afonsus1997/V3S-devboard/README.md

# V3S-devboard

## Hardware

Using V3S lib from https://github.com/balmerdx/AllwinnerV3S_KiCad

## Software

Build environment based on Funkey project
