afonsus1997/V3S-devboard/Hardware/V3S-devboard-module/V3S-devboard-module.kicad_pcb

## KiCad design Hardware/V3S-devboard-module/V3S-devboard-module.kicad_pcb (2024-05-04)

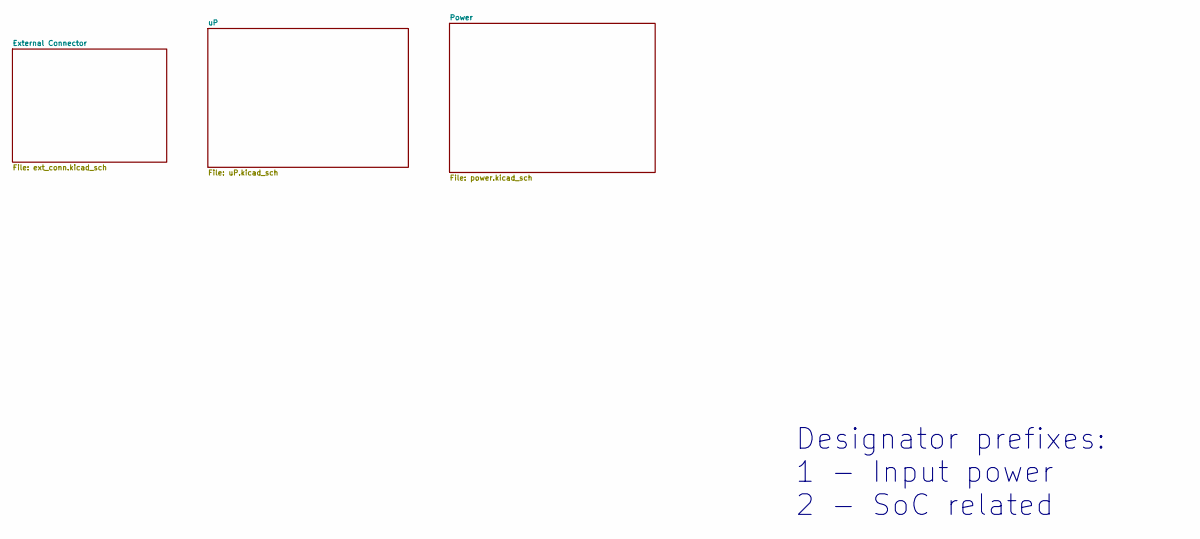
[picture p1: schematic V3S-devboard-module.kicad_sch]

Notes on the sheet:
Designator prefixes: 1 - Input power 2 - SoC related

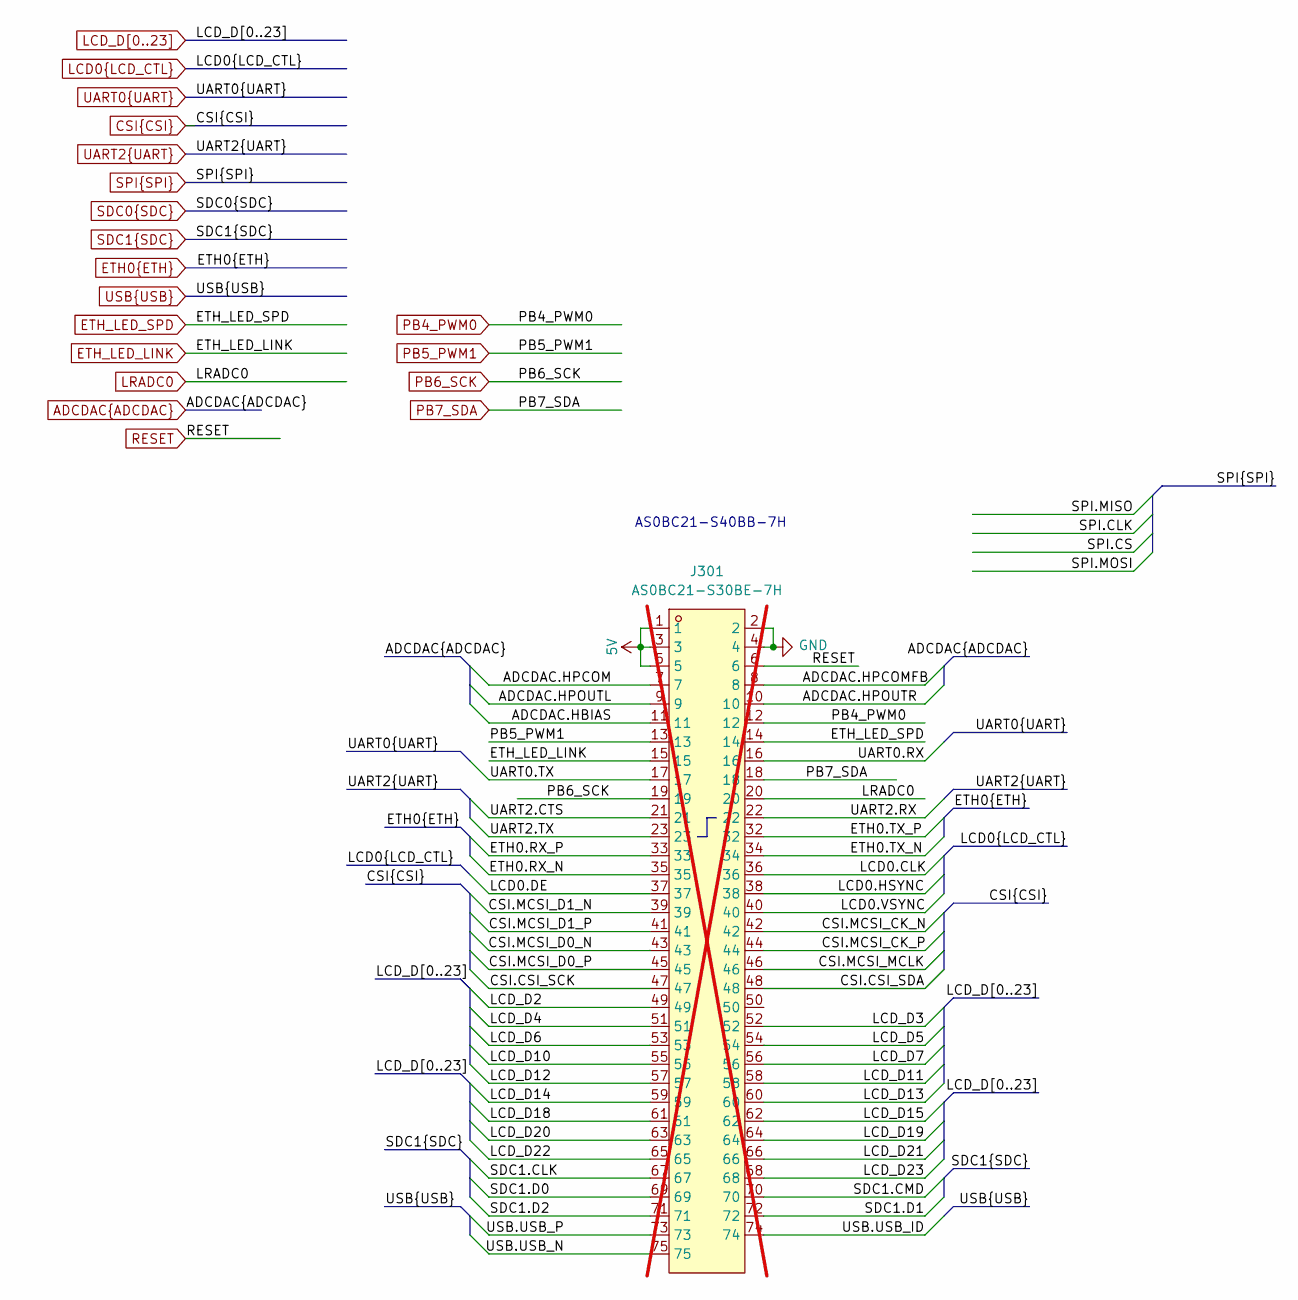
[picture p2: schematic ext_conn.kicad_sch, Power]

Parts:
J301: AS0BC21-S30BE-7H; m2-padKeyE; LCSC Part C3020019; not fitted

Connections:
5V: J301.1, J301.3, J301.5; also elsewhere on the board
ADCDAC.HBIAS: J301.11; also elsewhere on the board
ADCDAC.HPCOM: J301.7; also elsewhere on the board
ADCDAC.HPCOMFB: J301.8; also elsewhere on the board
ADCDAC.HPOUTL: J301.9; also elsewhere on the board
ADCDAC.HPOUTR: J301.10; also elsewhere on the board
CSI.CSI_SCK: J301.47; also elsewhere on the board
CSI.CSI_SDA: J301.48; also elsewhere on the board
CSI.MCSI_CK_N: J301.42; also elsewhere on the board
CSI.MCSI_CK_P: J301.44; also elsewhere on the board
CSI.MCSI_D0_N: J301.43; also elsewhere on the board
CSI.MCSI_D0_P: J301.45; also elsewhere on the board
CSI.MCSI_D1_N: J301.39; also elsewhere on the board
CSI.MCSI_D1_P: J301.41; also elsewhere on the board
CSI.MCSI_MCLK: J301.46; also elsewhere on the board
ETH0.RX_N: J301.35; also elsewhere on the board
ETH0.RX_P: J301.33; also elsewhere on the board
ETH0.TX_N: J301.34; also elsewhere on the board
ETH0.TX_P: J301.32; also elsewhere on the board
ETH_LED_LINK: J301.15; also elsewhere on the board
ETH_LED_SPD: J301.14; also elsewhere on the board
GND: J301.2, J301.4; also elsewhere on the board
LCD0.CLK: J301.36; also elsewhere on the board
LCD0.DE: J301.37; also elsewhere on the board
LCD0.HSYNC: J301.38; also elsewhere on the board
LCD0.VSYNC: J301.40; also elsewhere on the board
LCD_D2: J301.49; also elsewhere on the board
LCD_D3: J301.52; also elsewhere on the board
LCD_D4: J301.51; also elsewhere on the board
LCD_D5: J301.54; also elsewhere on the board
LCD_D6: J301.53; also elsewhere on the board
LCD_D7: J301.56; also elsewhere on the board
LCD_D10: J301.55; also elsewhere on the board
LCD_D11: J301.58; also elsewhere on the board
LCD_D12: J301.57; also elsewhere on the board
LCD_D13: J301.60; also elsewhere on the board
LCD_D14: J301.59; also elsewhere on the board
LCD_D15: J301.62; also elsewhere on the board
LCD_D18: J301.61; also elsewhere on the board
LCD_D19: J301.64; also elsewhere on the board
LCD_D20: J301.63; also elsewhere on the board
LCD_D21: J301.66; also elsewhere on the board
LCD_D22: J301.65; also elsewhere on the board
LCD_D23: J301.68; also elsewhere on the board
LRADC0: J301.20; also elsewhere on the board
PB4_PWM0: J301.12; also elsewhere on the board
PB5_PWM1: J301.13; also elsewhere on the board
PB6_SCK: J301.19; also elsewhere on the board
PB7_SDA: J301.18; also elsewhere on the board
RESET: J301.6; also elsewhere on the board
SDC1.CLK: J301.67; also elsewhere on the board
SDC1.CMD: J301.70; also elsewhere on the board
SDC1.D0: J301.69; also elsewhere on the board
SDC1.D1: J301.72; also elsewhere on the board
SDC1.D2: J301.71; also elsewhere on the board
UART0.RX: J301.16; also elsewhere on the board
UART0.TX: J301.17; also elsewhere on the board
UART2.CTS: J301.21; also elsewhere on the board
UART2.RX: J301.22; also elsewhere on the board
UART2.TX: J301.23; also elsewhere on the board
USB.USB_ID: J301.74; also elsewhere on the board
USB.USB_N: J301.75; also elsewhere on the board
USB.USB_P: J301.73; also elsewhere on the board

Notes on the sheet:
AS0BC21-S40BB-7H

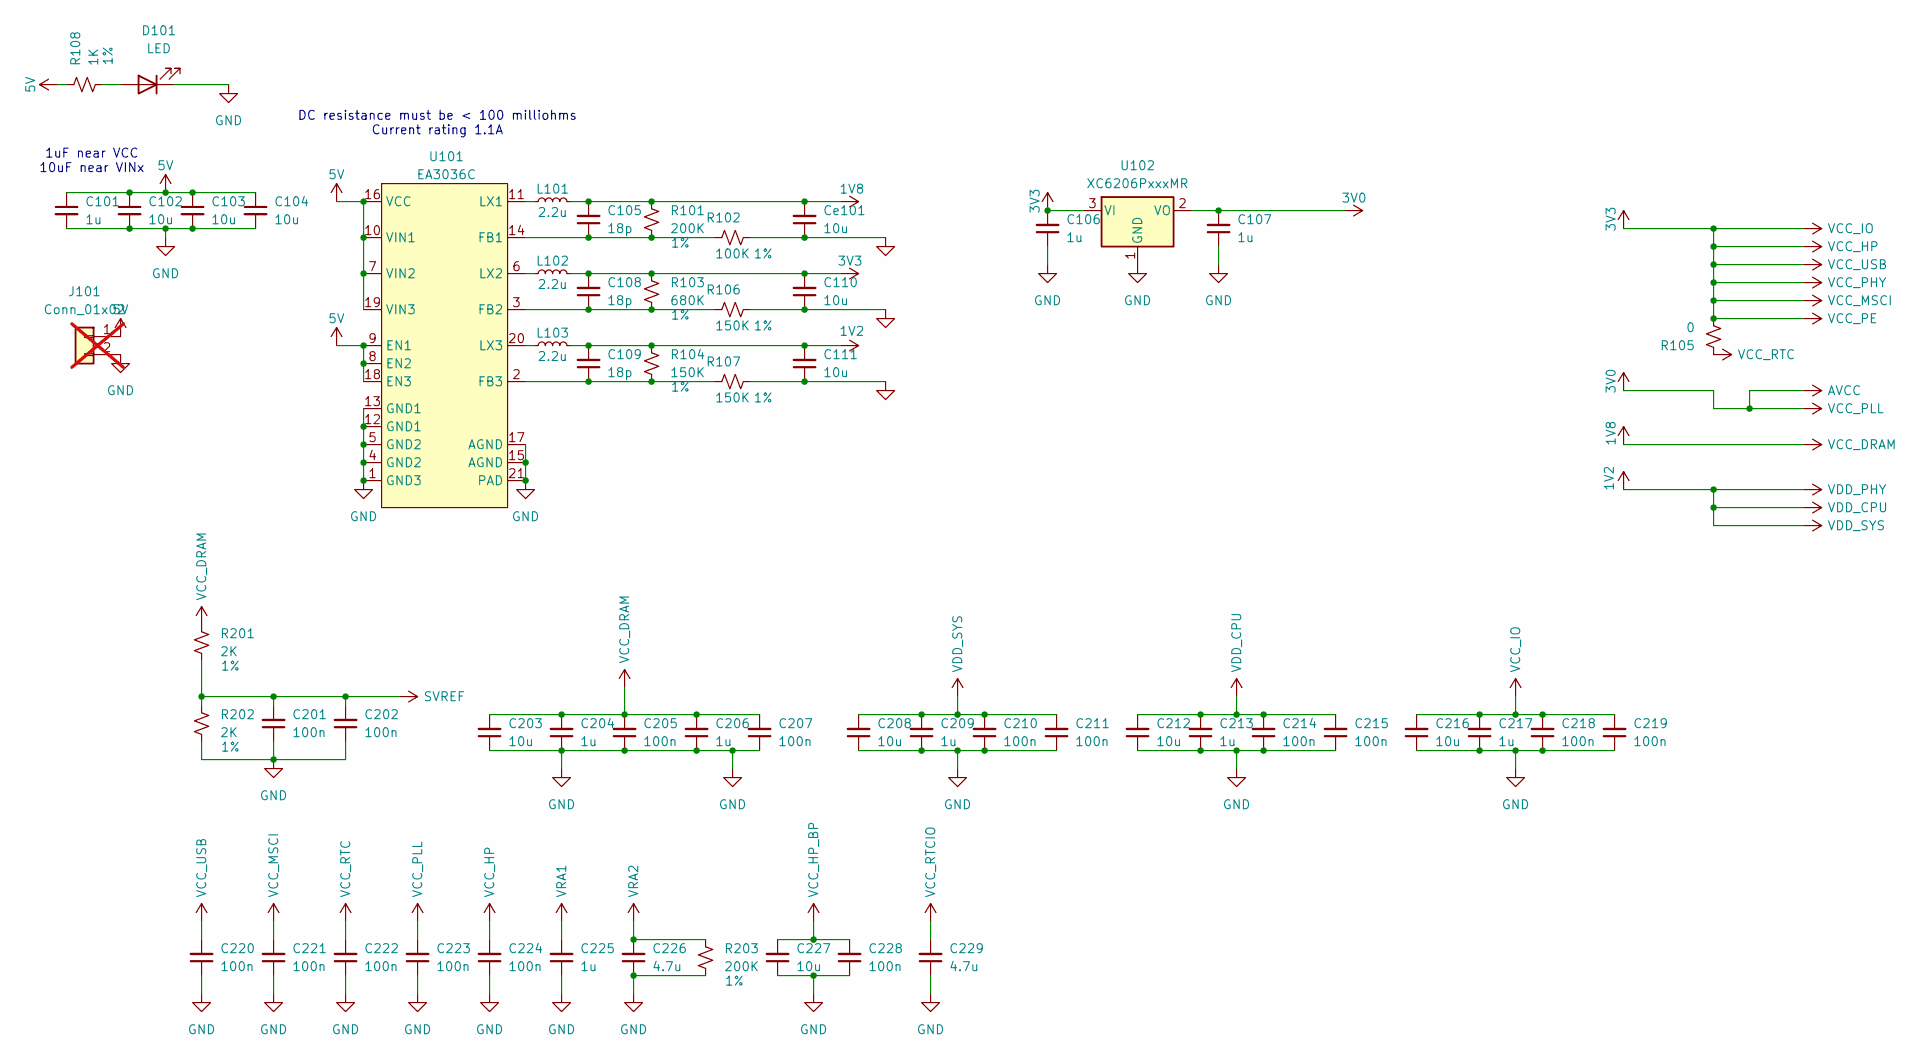
[picture p3: schematic power.kicad_sch]

Parts:
C101, C106, C107, C204, C206, C209, C213, C217, C225: 1u; C_0603_1608Metric; LCSC C5673
C102, C103, C104, C110, C111, C203, C208, C212, C216, C227: 10u; C_0603_1608Metric; LCSC C1691
C105, C108, C109: 18p; C_0402_1005Metric; LCSC C541431
C201, C202, C205, C207, C210, C211, C214, C215, C218, C219, C220, C221, C222, C223, C224, C228: 100n; C_0402_1005Metric; LCSC C1525
C226, C229: 4.7u; C_0603_1608Metric; LCSC C1705
Ce101: 10u; C_0603_1608Metric; LCSC C1691
D101: LED; LED_0603_1608Metric
J101: Conn_01x02; PinHeader_1x02_P2.54mm_Vertical; not fitted
L101, L102, L103: 2.2u; L_1008_2520Metric; LCSC C86092
R101, R203: 200K; R_0402_1005Metric; LCSC C114763
R102: 100K; R_0402_1005Metric; LCSC C60491
R103: 680K; R_0402_1005Metric; LCSC C163456
R104, R106, R107: 150K; R_0402_1005Metric; LCSC C93947
R105: 0; R_0402_1005Metric; LCSC C106231
R108: 1K; R_0402_1005Metric; LCSC C114763
R201, R202: 2K; R_0402_1005Metric; LCSC C60488
U101: EA3036C; WQFN-20-1EP_3x3mm_P0.4mm_EP1.7x1.7mm; LCSC C570857
U102: XC6206PxxxMR; SOT-23-3; LCSC C5148691

Connections:
1V2: C109.2, C111.2, C208.2, C209.2, C210.2, C211.2, C212.2, C213.2, C214.2, C215.2, L103.2, R104.1; also elsewhere on the board
1V8: C105.2, C203.2, C204.2, C205.2, C206.2, C207.2, Ce101.2, L101.2, R101.1, R201.1; also elsewhere on the board
3V0: C107.2, C223.2, U102.2 (VO); also elsewhere on the board
3V3: C106.2, C108.2, C110.2, C216.2, C217.2, C218.2, C219.2, C220.2, C221.2, C224.2, L102.2, R103.1, R105.2, U102.3 (VI); also elsewhere on the board
5V: C101.1, C102.1, C103.1, C104.1, J101.1, R108.1, U101.7 (VIN2), U101.8 (EN2), U101.9 (EN1), U101.10 (VIN1), U101.16 (VCC), U101.18 (EN3), U101.19 (VIN3); also elsewhere on the board
GND: C101.2, C102.2, C103.2, C104.2, C106.1, C107.1, C110.1, C111.1, C201.1, C202.1, C203.1, C204.1, C205.1, C206.1, C207.1, C208.1, C209.1, C210.1, C211.1, C212.1, C213.1, C214.1, C215.1, C216.1, C217.1, C218.1, C219.1, C220.1, C221.1, C222.1, C223.1, C224.1, C225.1, C226.1, C227.1, C228.1, C229.1, Ce101.1, D101.1 (K), J101.2, R102.2, R106.2, R107.2, R202.2, R203.2, U101.1 (GND3), U101.4 (GND2), U101.5 (GND2), U101.12 (GND1), U101.13 (GND1), U101.15 (AGND), U101.17 (AGND), U101.21 (PAD), U102.1 (GND); also elsewhere on the board
unnamed: D101.2 (A), R108.2
unnamed: C105.1, R101.2, R102.1, U101.14 (FB1)
unnamed: C108.1, R103.2, R106.1, U101.3 (FB2)
unnamed: C109.1, R104.2, R107.1, U101.2 (FB3)
unnamed: L101.1, U101.11 (LX1)
unnamed: L102.1, U101.6 (LX2)
unnamed: L103.1, U101.20 (LX3)
SVREF: C201.2, C202.2, R201.2, R202.1; also elsewhere on the board
VCC_HP_BP: C227.2, C228.2; also elsewhere on the board
VCC_RTC: C222.2, R105.1; also elsewhere on the board
VCC_RTCIO: C229.2; also elsewhere on the board
VRA1: C225.2; also elsewhere on the board
VRA2: C226.2, R203.1; also elsewhere on the board

Notes on the sheet:
DC resistance must be < 100 milliohms Current rating 1.1A
1uF near VCC 10uF near VINx

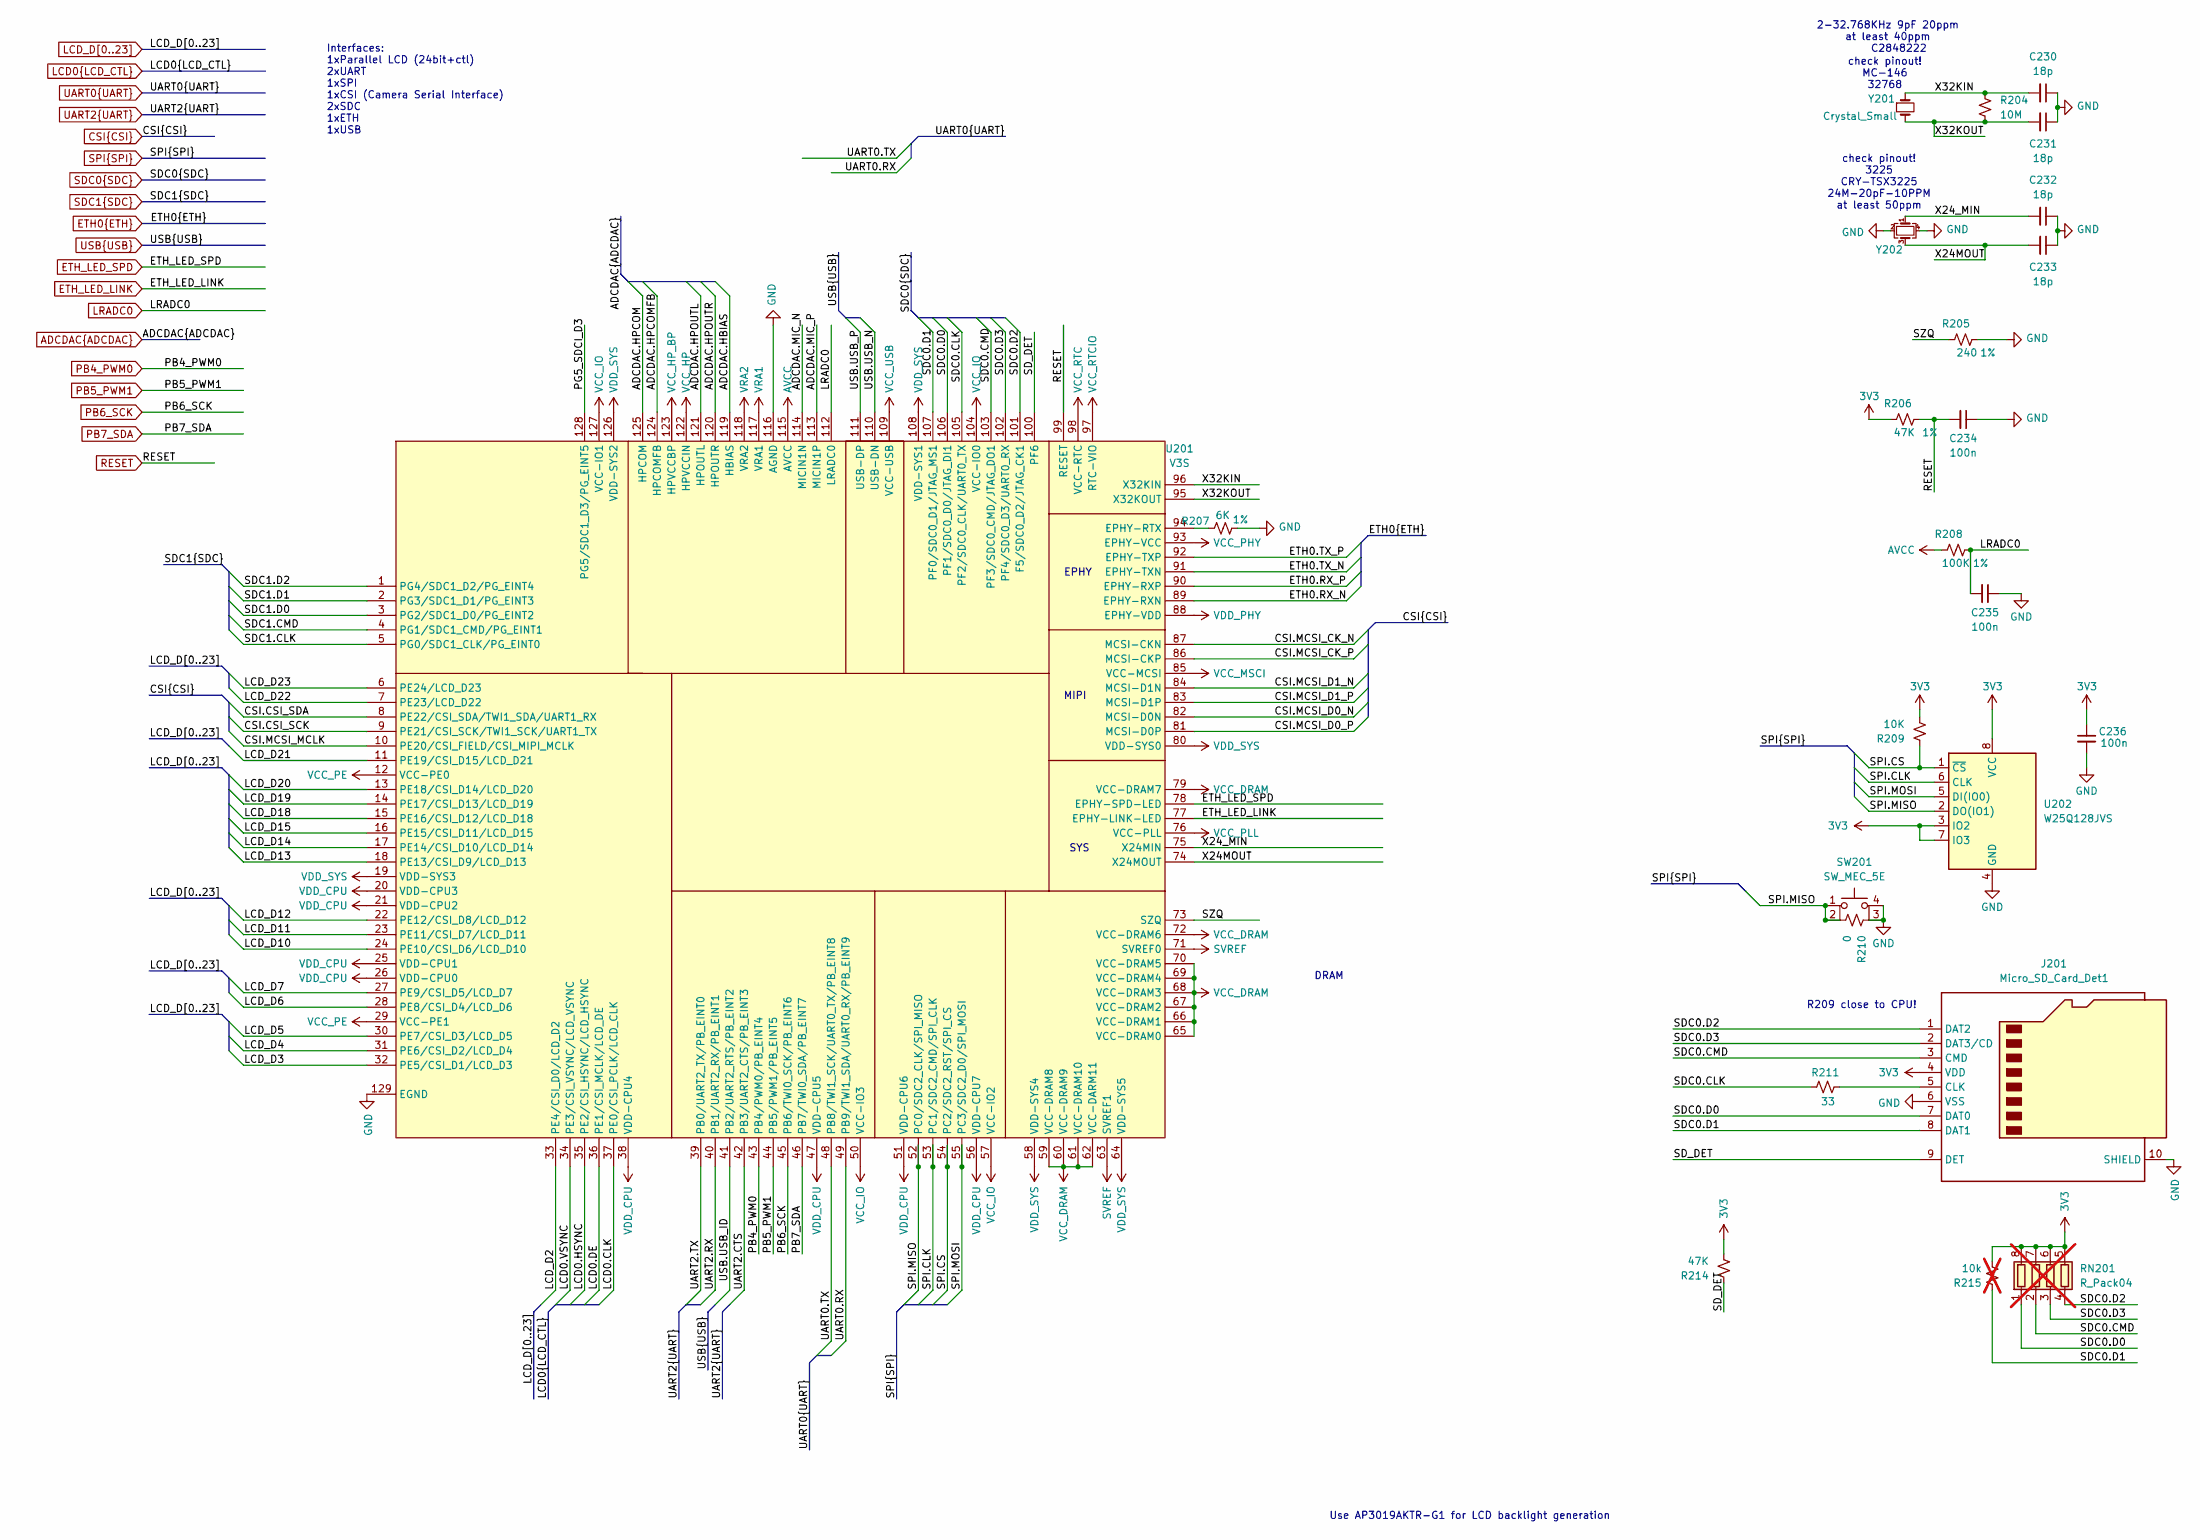
[picture p4: schematic uP.kicad_sch]

Parts:
C230, C231, C232, C233: 18p; C_0402_1005Metric; LCSC C541431
C234, C235, C236: 100n; C_0402_1005Metric; LCSC C1525
J201: Micro_SD_Card_Det1; J_sd_micro_socket; LCSC C7529389
R204: 10M; R_0402_1005Metric; LCSC C138067
R205: 240; R_0402_1005Metric; LCSC C114755
R206, R214: 47K; R_0402_1005Metric; LCSC C93943
R207: 6K; R_0805_2012Metric; LCSC C2828725
R208: 100K; R_0402_1005Metric; LCSC C60491
R209: 10K; R_0402_1005Metric; LCSC C60490
R210: 0; R_0402_1005Metric; LCSC C106231
R211: 33; R_0402_1005Metric; LCSC C138002
R215: 10k; R_0402_1005Metric; LCSC C60490; not fitted
RN201: R_Pack04; R_Array_Concave_4x0402; LCSC C1736647; not fitted
SW201: SW_MEC_5E; SW_SKRPACE010; LCSC C139797
U201: V3S; LQFP-128_L14.0-W14.0-P0.40-LS16.0-BL-EP5.0; LCSC C2687449
U202: W25Q128JVS; SOIC-8_5.23x5.23mm_P1.27mm; LCSC C97521
Y201: Crystal_Small; Crystal_SMD_3215-2Pin_3.2x1.5mm; LCSC C2848222
Y202: Crystal_GND24_Small; Crystal_SMD_2520-4Pin_2.5x2.0mm; LCSC C15643

Connections:
1V2: U201.19 (VDD-SYS3), U201.20 (VDD-CPU3), U201.21 (VDD-CPU2), U201.25 (VDD-CPU1), U201.26 (VDD-CPU0), U201.38 (VDD-CPU4), U201.47 (VDD-CPU5), U201.51 (VDD-CPU6), U201.56 (VDD-CPU7), U201.58 (VDD-SYS4), U201.64 (VDD-SYS5), U201.80 (VDD-SYS0), U201.88 (EPHY-VDD), U201.108 (VDD-SYS1), U201.126 (VDD-SYS2); also elsewhere on the board
1V8: U201.59 (VCC-DRAM8), U201.60 (VCC-DRAM9), U201.61 (VCC-DRAM10), U201.62 (VCC-DARM11), U201.65 (VCC-DRAM0), U201.66 (VCC-DRAM1), U201.67 (VCC-DRAM2), U201.68 (VCC-DRAM3), U201.69 (VCC-DRAM4), U201.70 (VCC-DRAM5), U201.72 (VCC-DRAM6), U201.79 (VCC-DRAM7); also elsewhere on the board
3V0: R208.1, U201.76 (VCC-PLL), U201.115 (AVCC); also elsewhere on the board
3V3: C236.1, J201.4 (VDD), R206.1, R209.2, R214.2, R215.2, RN201.5 (R4.2), RN201.6 (R3.2), RN201.7 (R2.2), RN201.8 (R1.2), U201.12 (VCC-PE0), U201.29 (VCC-PE1), U201.50 (VCC-IO3), U201.57 (VCC-IO2), U201.85 (VCC-MCSI), U201.93 (EPHY-VCC), U201.104 (VCC-IO0), U201.109 (VCC-USB), U201.122 (HPVCCIN), U201.127 (VCC-IO1), U202.3 (IO2), U202.7 (IO3), U202.8 (VCC); also elsewhere on the board
/uP/PG5_SDCI_D3: U201.128 (PG5/SDC1_D3/PG_EINT5)
/uP/SD_DET: J201.9 (DET), R214.1, U201.100 (PF6)
/uP/SZQ: R205.1, U201.73 (SZQ)
/uP/X24MOUT: C233.2, U201.74 (X24MOUT), Y202.3
/uP/X24_MIN: C232.2, U201.75 (X24MIN), Y202.1
/uP/X32KIN: C230.2, R204.1, U201.96 (X32KIN), Y201.1
/uP/X32KOUT: C231.2, R204.2, U201.95 (X32KOUT), Y201.2
ADCDAC.HBIAS: U201.119 (HBIAS); also elsewhere on the board
ADCDAC.HPCOM: U201.125 (HPCOM); also elsewhere on the board
ADCDAC.HPCOMFB: U201.124 (HPCOMFB); also elsewhere on the board
ADCDAC.HPOUTL: U201.121 (HPOUTL); also elsewhere on the board
ADCDAC.HPOUTR: U201.120 (HPOUTR); also elsewhere on the board
ADCDAC.MIC_N: U201.114 (MICIN1N)
ADCDAC.MIC_P: U201.113 (MICIN1P)
CSI.CSI_SCK: U201.9 (PE21/CSI_SCK/TWI1_SCK/UART1_TX); also elsewhere on the board
CSI.CSI_SDA: U201.8 (PE22/CSI_SDA/TWI1_SDA/UART1_RX); also elsewhere on the board
CSI.MCSI_CK_N: U201.87 (MCSI-CKN); also elsewhere on the board
CSI.MCSI_CK_P: U201.86 (MCSI-CKP); also elsewhere on the board
CSI.MCSI_D0_N: U201.82 (MCSI-D0N); also elsewhere on the board
CSI.MCSI_D0_P: U201.81 (MCSI-D0P); also elsewhere on the board
CSI.MCSI_D1_N: U201.84 (MCSI-D1N); also elsewhere on the board
CSI.MCSI_D1_P: U201.83 (MCSI-D1P); also elsewhere on the board
CSI.MCSI_MCLK: U201.10 (PE20/CSI_FIELD/CSI_MIPI_MCLK); also elsewhere on the board
ETH0.RX_N: U201.89 (EPHY-RXN); also elsewhere on the board
ETH0.RX_P: U201.90 (EPHY-RXP); also elsewhere on the board
ETH0.TX_N: U201.91 (EPHY-TXN); also elsewhere on the board
ETH0.TX_P: U201.92 (EPHY-TXP); also elsewhere on the board
ETH_LED_LINK: U201.77 (EPHY-LINK-LED); also elsewhere on the board
ETH_LED_SPD: U201.78 (EPHY-SPD-LED); also elsewhere on the board
GND: C230.1, C231.1, C232.1, C233.1, C234.1, C235.1, C236.2, J201.6 (VSS), J201.10 (SHIELD), R205.2, R207.2, R210.1, SW201.3 (K), SW201.4 (A), U201.116 (AGND), U201.129 (EGND), U202.4 (GND), Y202.2, Y202.4; also elsewhere on the board
LCD0.CLK: U201.37 (PE0/CSI_PCLK/LCD_CLK); also elsewhere on the board
LCD0.DE: U201.36 (PE1/CSI_MCLK/LCD_DE); also elsewhere on the board
LCD0.HSYNC: U201.35 (PE2/CSI_HSYNC/LCD_HSYNC); also elsewhere on the board
LCD0.VSYNC: U201.34 (PE3/CSI_VSYNC/LCD_VSYNC); also elsewhere on the board
LCD_D2: U201.33 (PE4/CSI_D0/LCD_D2); also elsewhere on the board
LCD_D3: U201.32 (PE5/CSI_D1/LCD_D3); also elsewhere on the board
LCD_D4: U201.31 (PE6/CSI_D2/LCD_D4); also elsewhere on the board
LCD_D5: U201.30 (PE7/CSI_D3/LCD_D5); also elsewhere on the board
LCD_D6: U201.28 (PE8/CSI_D4/LCD_D6); also elsewhere on the board
LCD_D7: U201.27 (PE9/CSI_D5/LCD_D7); also elsewhere on the board
LCD_D10: U201.24 (PE10/CSI_D6/LCD_D10); also elsewhere on the board
LCD_D11: U201.23 (PE11/CSI_D7/LCD_D11); also elsewhere on the board
LCD_D12: U201.22 (PE12/CSI_D8/LCD_D12); also elsewhere on the board
LCD_D13: U201.18 (PE13/CSI_D9/LCD_D13); also elsewhere on the board
LCD_D14: U201.17 (PE14/CSI_D10/LCD_D14); also elsewhere on the board
LCD_D15: U201.16 (PE15/CSI_D11/LCD_D15); also elsewhere on the board
LCD_D18: U201.15 (PE16/CSI_D12/LCD_D18); also elsewhere on the board
LCD_D19: U201.14 (PE17/CSI_D13/LCD_D19); also elsewhere on the board
LCD_D20: U201.13 (PE18/CSI_D14/LCD_D20); also elsewhere on the board
LCD_D21: U201.11 (PE19/CSI_D15/LCD_D21); also elsewhere on the board
LCD_D22: U201.7 (PE23/LCD_D22); also elsewhere on the board
LCD_D23: U201.6 (PE24/LCD_D23); also elsewhere on the board
LRADC0: C235.2, R208.2, U201.112 (LRADC0); also elsewhere on the board
unnamed: J201.5 (CLK), R211.2
unnamed: R207.1, U201.94 (EPHY-RTX)
PB4_PWM0: U201.43 (PB4/PWM0/PB_EINT4); also elsewhere on the board
PB5_PWM1: U201.44 (PB5/PWM1/PB_EINT5); also elsewhere on the board
PB6_SCK: U201.45 (PB6/TWI0_SCK/PB_EINT6); also elsewhere on the board
PB7_SDA: U201.46 (PB7/TWI0_SDA/PB_EINT7); also elsewhere on the board
RESET: C234.2, R206.2, U201.99 (RESET); also elsewhere on the board
SDC0.CLK: R211.1, U201.105 (PF2/SDC0_CLK/UART0_TX)
SDC0.CMD: J201.3 (CMD), RN201.2 (R2.1), U201.103 (PF3/SDC0_CMD/JTAG_DO1)
SDC0.D0: J201.7 (DAT0), RN201.1 (R1.1), U201.106 (PF1/SDC0_D0/JTAG_DI1)
SDC0.D1: J201.8 (DAT1), R215.1, U201.107 (PF0/SDC0_D1/JTAG_MS1)
SDC0.D2: J201.1 (DAT2), RN201.4 (R4.1), U201.101 (F5/SDC0_D2/JTAG_CK1)
SDC0.D3: J201.2 (DAT3/CD), RN201.3 (R3.1), U201.102 (PF4/SDC0_D3/UART0_RX)
SDC1.CLK: U201.5 (PG0/SDC1_CLK/PG_EINT0); also elsewhere on the board
SDC1.CMD: U201.4 (PG1/SDC1_CMD/PG_EINT1); also elsewhere on the board
SDC1.D0: U201.3 (PG2/SDC1_D0/PG_EINT2); also elsewhere on the board
SDC1.D1: U201.2 (PG3/SDC1_D1/PG_EINT3); also elsewhere on the board
SDC1.D2: U201.1 (PG4/SDC1_D2/PG_EINT4); also elsewhere on the board
SPI.CLK: U201.53 (PC1/SDC2_CMD/SPI_CLK), U202.6 (CLK)
SPI.CS: R209.1, U201.54 (PC2/SDC2_RST/SPI_CS), U202.1 (~CS)
SPI.MISO: R210.2, SW201.1, SW201.2, U201.52 (PC0/SDC2_CLK/SPI_MISO), U202.2 (DO(IO1))
SPI.MOSI: U201.55 (PC3/SDC2_D0/SPI_MOSI), U202.5 (DI(IO0))
SVREF: U201.63 (SVREF1), U201.71 (SVREF0); also elsewhere on the board
UART0.RX: U201.49 (PB9/TWI1_SDA/UART0_RX/PB_EINT9); also elsewhere on the board
UART0.TX: U201.48 (PB8/TWI1_SCK/UART0_TX/PB_EINT8); also elsewhere on the board
UART2.CTS: U201.42 (PB3/UART2_CTS/PB_EINT3); also elsewhere on the board
UART2.RX: U201.40 (PB1/UART2_RX/PB_EINT1); also elsewhere on the board
UART2.TX: U201.39 (PB0/UART2_TX/PB_EINT0); also elsewhere on the board
USB.USB_ID: U201.41 (PB2/UART2_RTS/PB_EINT2); also elsewhere on the board
USB.USB_N: U201.110 (USB-DN); also elsewhere on the board
USB.USB_P: U201.111 (USB-DP); also elsewhere on the board
VCC_HP_BP: U201.123 (HPVCCBP); also elsewhere on the board
VCC_RTC: U201.98 (VCC-RTC); also elsewhere on the board
VCC_RTCIO: U201.97 (RTC-VIO); also elsewhere on the board
VRA1: U201.117 (VRA1); also elsewhere on the board
VRA2: U201.118 (VRA2); also elsewhere on the board

Notes on the sheet:
DRAM
check pinout! 3225 CRY-TSX3225 24M-20pF-10PPM at least 50ppm
Interfaces: 1xParallel LCD (24bit+ctl) 2xUART 1xSPI 1xCSI (Camera Serial Interface) 2xSDC 1xETH 1xUSB
EPHY
2-32.768KHz 9pF 20ppm at least 40ppm C2848222
check pinout! MC-146 32768
R209 close to CPU!
MIPI
Use AP3019AKTR-G1 for LCD backlight generation
SYS

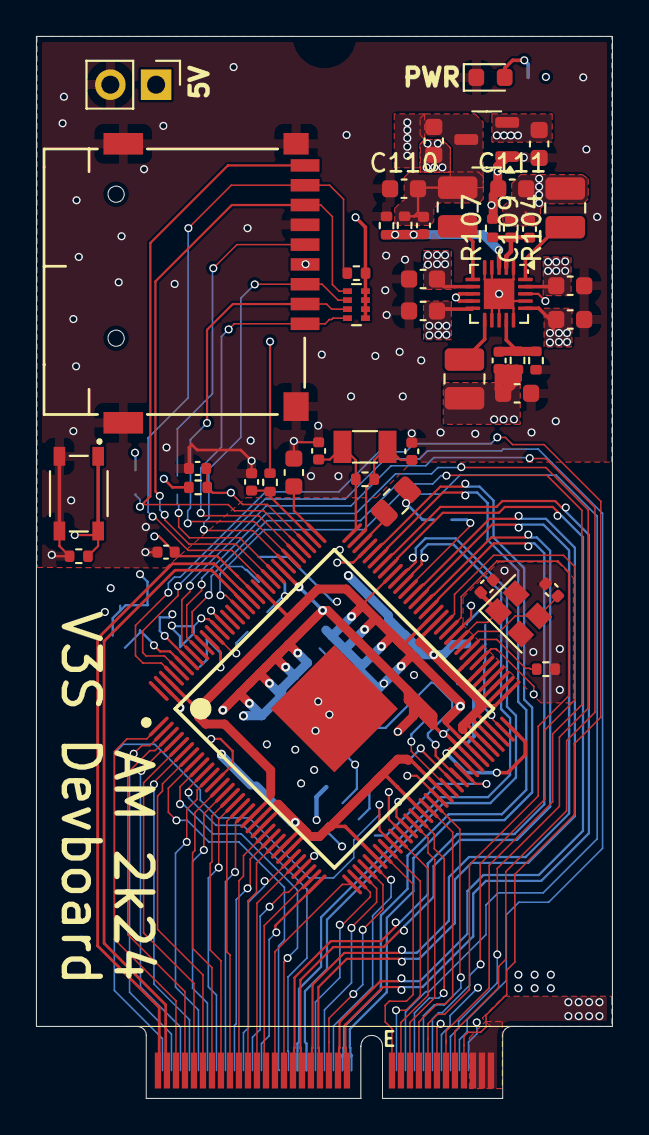
[picture p5: board V3S-devboard-module.kicad_pcb from above]

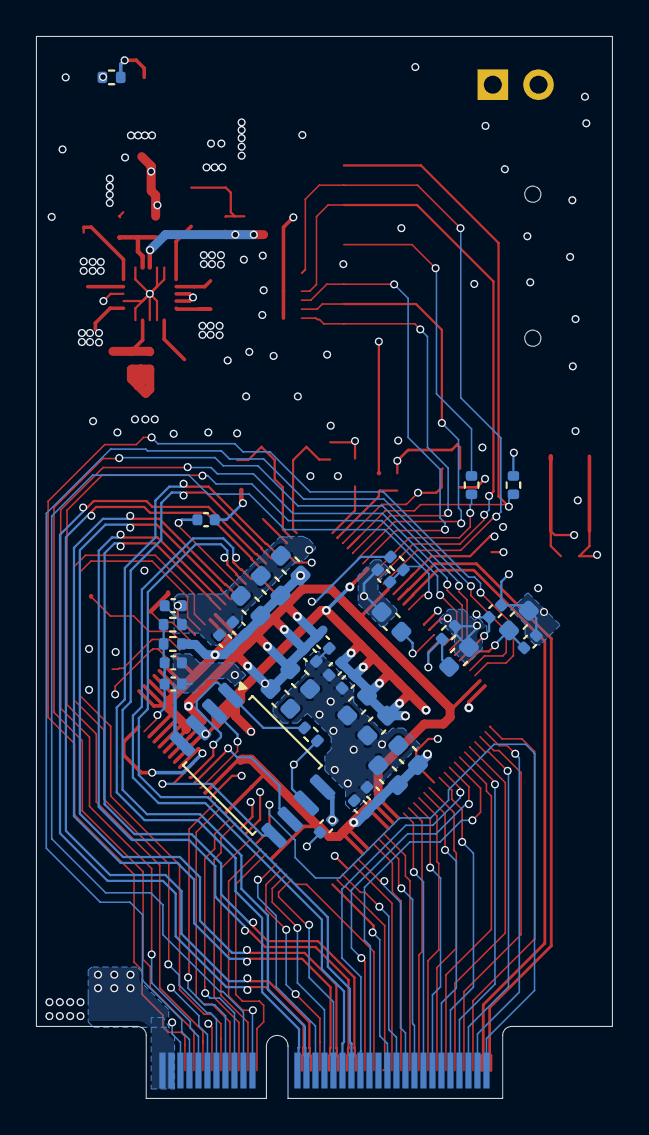
[picture p6: board V3S-devboard-module.kicad_pcb from below]

Board: 4 copper layers, 32.0 x 59.0 mm, 84 parts (37 on the bottom side), 98 nets.
