afonsus1997/V3S-devboard/Hardware/V3S-devboard-expansion-minimal/V3S-devboard-expansion-minimal.kicad_pcb

## KiCad design Hardware/V3S-devboard-expansion-minimal/V3S-devboard-expansion-minimal.kicad_pcb (2024-04-12)

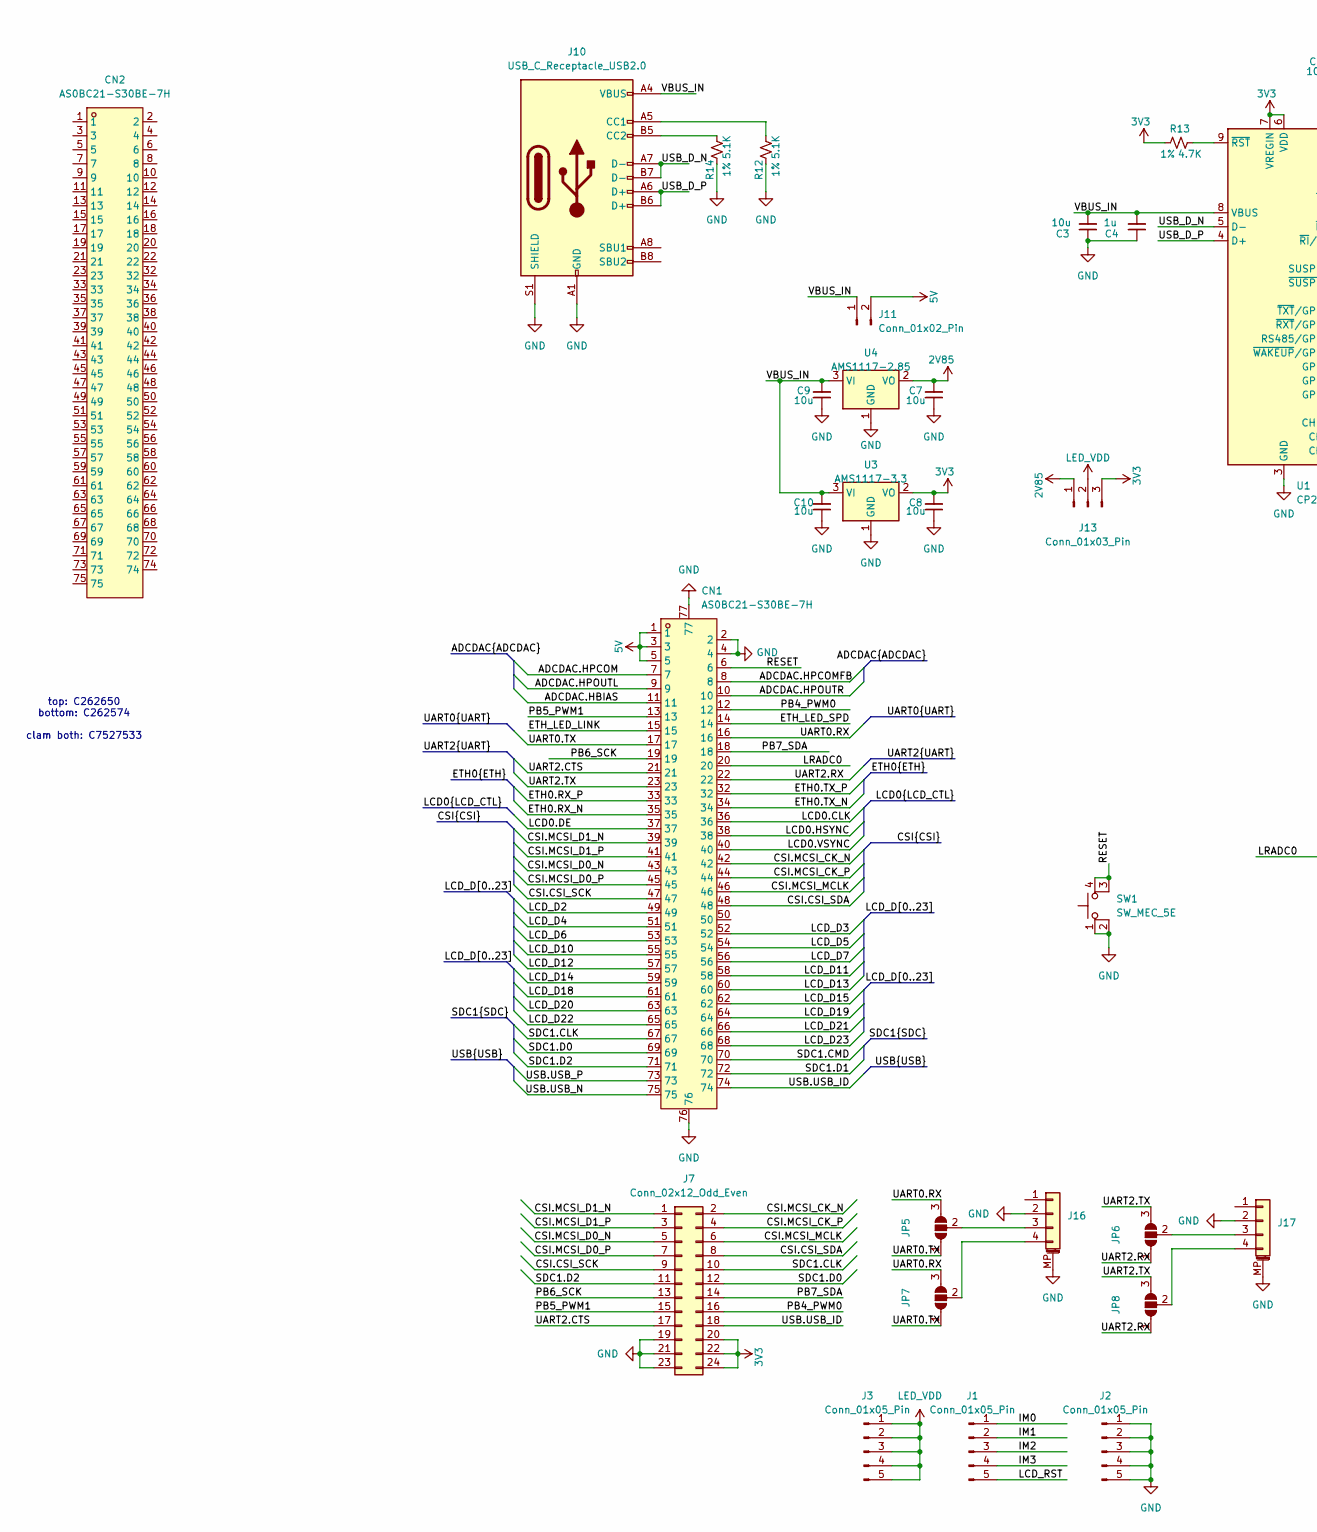
[picture p7: schematic V3S-devboard-expansion-minimal.kicad_sch, part in row 1, column 1]

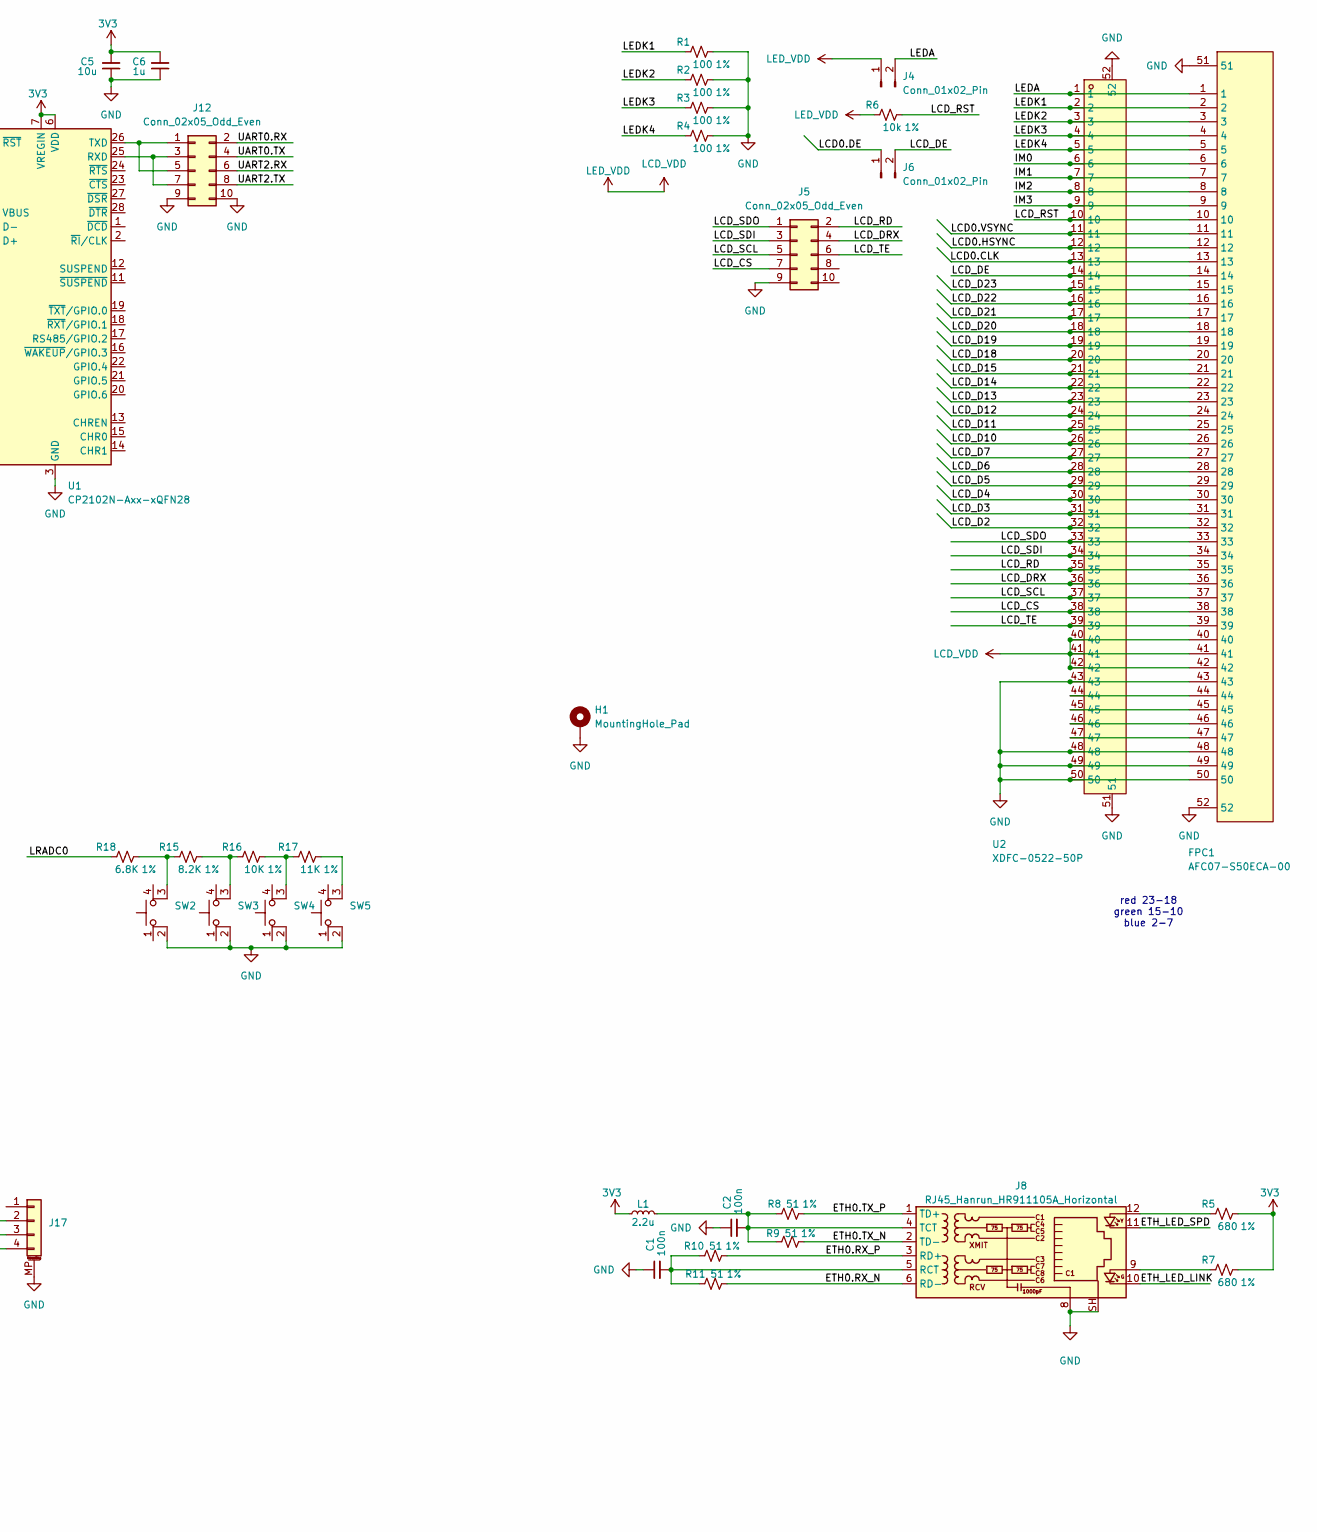
[picture p8: schematic V3S-devboard-expansion-minimal.kicad_sch, part in row 1, column 2]

Parts:
C1, C2: 100n; C_0603_1608Metric; LCSC C1525
C3, C5, C7, C8, C9, C10: 10u; C_0603_1608Metric; LCSC C1525
C4, C6: 1u; C_0603_1608Metric; LCSC C1525
CN1: AS0BC21-S30BE-7H; CONN-SMD_AS0BC21-S30BE-7H; LCSC Part C3020019
CN2: AS0BC21-S30BE-7H; m2-padKeyE; LCSC Part C3020019
FPC1: AFC07-S50ECA-00; FPC-SMD_AFC07-S50ECA-00; LCSC C262650
H1: MountingHole_Pad; screwnut; LCSC C2928188
J1, J2, J3: Conn_01x05_Pin; PinHeader_1x05_P2.54mm_Vertical
J4, J6, J11: Conn_01x02_Pin; PinHeader_1x02_P2.54mm_Vertical
J5: Conn_02x05_Odd_Even; PinHeader_2x05_P2.54mm_Vertical
J7: Conn_02x12_Odd_Even; PinSocket_2x12_P2.54mm_Vertical; LCSC C2685134
J8: RJ45_Hanrun_HR911105A_Horizontal; LCSC C12074
J10: USB_C_Receptacle_USB2.0; USB_C_Receptacle_HCTL_HC-TYPE-C-16P-01A; LCSC C2894897
J12: Conn_02x05_Odd_Even; PinHeader_2x05_P2.54mm_Vertical_SMD
J13: Conn_01x03_Pin; PinSocket_1x03_P2.54mm_Vertical
J16, J17: Conn_01x04_MountingPin; CONN-SMD_HCZZ0021-4; LCSC C7433709
JP5, JP6, JP7, JP8: SolderJumper_3_Open; SolderJumper-3_P1.3mm_Open_RoundedPad1.0x1.5mm_NumberLabels
L1: 2.2u; L_1008_2520Metric; LCSC C86092
R1, R2, R3, R4: 100; R_0603_1608Metric; LCSC C60491
R5, R7: 680; R_0603_1608Metric; LCSC C60491
R6: 10k; R_0402_1005Metric; LCSC C60491
R8, R9, R10, R11: 51; R_0603_1608Metric; LCSC C60491
R12, R14: 5.1K; R_0603_1608Metric; LCSC C60491
R13: 4.7K; R_0603_1608Metric; LCSC C60491
R15: 8.2K; R_0603_1608Metric; LCSC C25981
R16: 10K; R_0603_1608Metric; LCSC C25804
R17: 11K; R_0603_1608Metric; LCSC C103227
R18: 6.8K; R_0603_1608Metric; LCSC C23212
SW1, SW2, SW3, SW4, SW5: SW_MEC_5E; SW_SKRPACE010; LCSC C139797
U1: CP2102N-Axx-xQFN28; QFN-28-1EP_5x5mm_P0.5mm_EP3.1x3.1mm; LCSC C964632
U2: XDFC-0522-50P; FPC-SMD_50P-P0.50_LX_XDFC-0522-50P; LCSC Part C7527533
U3: AMS1117-3.3; SOT-223-3_TabPin2; LCSC C426566
U4: AMS1117-2.85; SOT-223-3_TabPin2; LCSC C14791

Connections:
2V85: C7.2, J13.1, U4.2 (VO)
3V3: C5.2, C6.2, C8.2, J7.20, J7.22, J7.24, J13.3, L1.1, R5.2, R7.2, R13.2, U1.6 (VDD), U1.7 (VREGIN), U3.2 (VO)
5V: CN1.1, CN1.3, CN1.5, J11.2
/ADCDAC.HBIAS: CN1.11
/ADCDAC.HPCOM: CN1.7
/ADCDAC.HPCOMFB: CN1.8
/ADCDAC.HPOUTL: CN1.9
/ADCDAC.HPOUTR: CN1.10
/CSI.CSI_SCK: CN1.47, J7.9
/CSI.CSI_SDA: CN1.48, J7.8
/CSI.MCSI_CK_N: CN1.42, J7.2
/CSI.MCSI_CK_P: CN1.44, J7.4
/CSI.MCSI_D0_N: CN1.43, J7.5
/CSI.MCSI_D0_P: CN1.45, J7.7
/CSI.MCSI_D1_N: CN1.39, J7.1
/CSI.MCSI_D1_P: CN1.41, J7.3
/CSI.MCSI_MCLK: CN1.46, J7.6
/ETH0.RX_N: CN1.35, J8.6 (RD-), R11.2
/ETH0.RX_P: CN1.33, J8.3 (RD+), R10.2
/ETH0.TX_N: CN1.34, J8.2 (TD-), R9.2
/ETH0.TX_P: CN1.32, J8.1 (TD+), R8.2
/ETH_LED_LINK: CN1.15, J8.10
/ETH_LED_SPD: CN1.14, J8.11
/IM0: FPC1.6, J1.1, U2.6
/IM1: FPC1.7, J1.2, U2.7
/IM2: FPC1.8, J1.3, U2.8
/IM3: FPC1.9, J1.4, U2.9
/LCD0.CLK: CN1.36, FPC1.13, U2.13
/LCD0.DE: CN1.37, J6.1
/LCD0.HSYNC: CN1.38, FPC1.12, U2.12
/LCD0.VSYNC: CN1.40, FPC1.11, U2.11
/LCD_CS: FPC1.38, J5.7, U2.38
/LCD_D2: CN1.49, FPC1.32, U2.32
/LCD_D3: CN1.52, FPC1.31, U2.31
/LCD_D4: CN1.51, FPC1.30, U2.30
/LCD_D5: CN1.54, FPC1.29, U2.29
/LCD_D6: CN1.53, FPC1.28, U2.28
/LCD_D7: CN1.56, FPC1.27, U2.27
/LCD_D10: CN1.55, FPC1.26, U2.26
/LCD_D11: CN1.58, FPC1.25, U2.25
/LCD_D12: CN1.57, FPC1.24, U2.24
/LCD_D13: CN1.60, FPC1.23, U2.23
/LCD_D14: CN1.59, FPC1.22, U2.22
/LCD_D15: CN1.62, FPC1.21, U2.21
/LCD_D18: CN1.61, FPC1.20, U2.20
/LCD_D19: CN1.64, FPC1.19, U2.19
/LCD_D20: CN1.63, FPC1.18, U2.18
/LCD_D21: CN1.66, FPC1.17, U2.17
/LCD_D22: CN1.65, FPC1.16, U2.16
/LCD_D23: CN1.68, FPC1.15, U2.15
/LCD_DE: FPC1.14, J6.2, U2.14
/LCD_DRX: FPC1.36, J5.4, U2.36
/LCD_RD: FPC1.35, J5.2, U2.35
/LCD_RST: FPC1.10, J1.5, R6.2, U2.10
/LCD_SCL: FPC1.37, J5.5, U2.37
/LCD_SDI: FPC1.34, J5.3, U2.34
/LCD_SDO: FPC1.33, J5.1, U2.33
/LCD_TE: FPC1.39, J5.6, U2.39
/LEDA: FPC1.1, J4.2, U2.1
/LEDK1: FPC1.2, R1.1, U2.2
/LEDK2: FPC1.3, R2.1, U2.3
/LEDK3: FPC1.4, R3.1, U2.4
/LEDK4: FPC1.5, R4.1, U2.5
/LRADC0: CN1.20, R18.1
/PB4_PWM0: CN1.12, J7.16
/PB5_PWM1: CN1.13, J7.15
/PB6_SCK: CN1.19, J7.13
/PB7_SDA: CN1.18, J7.14
/RESET: CN1.6, SW1.3 (K), SW1.4 (A)
/SDC1.CLK: CN1.67, J7.10
/SDC1.CMD: CN1.70
/SDC1.D0: CN1.69, J7.12
/SDC1.D1: CN1.72
/SDC1.D2: CN1.71, J7.11
/UART0.RX: CN1.16, J12.2, JP5.3 (B), JP7.3 (B)
/UART0.TX: CN1.17, J12.4, JP5.1 (A), JP7.1 (A)
/UART2.CTS: CN1.21, J7.17
/UART2.RX: CN1.22, J12.6, JP6.1 (A), JP8.1 (A)
/UART2.TX: CN1.23, J12.8, JP6.3 (B), JP8.3 (B)
/USB.USB_ID: CN1.74, J7.18
/USB.USB_N: CN1.75
/USB.USB_P: CN1.73
/USB_D_N: J10.A7 (D-), J10.B7 (D-), U1.5 (D-)
/USB_D_P: J10.A6 (D+), J10.B6 (D+), U1.4 (D+)
/VBUS_IN: C3.2, C4.2, C9.2, C10.2, J10.A4 (VBUS), J10.A9 (VBUS), J10.B4 (VBUS), J10.B9 (VBUS), J11.1, U1.8 (VBUS), U3.3 (VI), U4.3 (VI)
GND: C1.1, C2.1, C3.1, C4.1, C5.1, C6.1, C7.1, C8.1, C9.1, C10.1, CN1.2, CN1.4, CN1.76, CN1.77, FPC1.43, FPC1.48, FPC1.49, FPC1.50, FPC1.51, FPC1.52, H1.1, J2.1, J2.2, J2.3, J2.4, J2.5, J5.9, J7.19, J7.21, J7.23, J8.8, J8.SH, J10.A1 (GND), J10.A12 (GND), J10.B1 (GND), J10.B12 (GND), J10.S1 (SHIELD), J12.9, J12.10, J16.2, J16.MP (MountPin), J17.2, J17.MP (MountPin), R1.2, R2.2, R3.2, R4.2, R12.2, R14.2, SW1.1, SW1.2, SW2.2, SW3.2, SW4.2, SW5.2, U1.3 (GND), U1.29 (GND), U2.43, U2.48, U2.49, U2.50, U2.51, U2.52, U3.1 (GND), U4.1 (GND)
LCD_VDD: FPC1.40, FPC1.41, FPC1.42, J3.1, J3.2, J3.3, J3.4, J3.5, J4.1, J13.2, R6.1, U2.40, U2.41, U2.42
unnamed: FPC1.44, U2.44
unnamed: FPC1.45, U2.45
unnamed: FPC1.46, U2.46
unnamed: FPC1.47, U2.47
unnamed: J8.9, R7.1
unnamed: J8.12, R5.1
unnamed: C1.2, J8.5 (RCT), R10.1, R11.1
unnamed: C2.2, J8.4 (TCT), L1.2, R8.1, R9.1
unnamed: J10.A5 (CC1), R12.1
unnamed: J10.B5 (CC2), R14.1
unnamed: J12.1, J12.5, U1.26 (TXD)
unnamed: J12.3, J12.7, U1.25 (RXD)
unnamed: J16.3, JP5.2 (C)
unnamed: J16.4, JP7.2 (C)
unnamed: J17.3, JP6.2 (C)
unnamed: J17.4, JP8.2 (C)
unnamed: R15.1, R18.2, SW2.3 (K)
unnamed: R15.2, R16.1, SW3.3 (K)
unnamed: R16.2, R17.1, SW4.3 (K)
unnamed: R17.2, SW5.3 (K)
unnamed: R13.1, U1.9 (~RST)

Notes on the sheet:
red 23-18 green 15-10 blue 2-7
top: C262650 bottom: C262574 clam both: C7527533

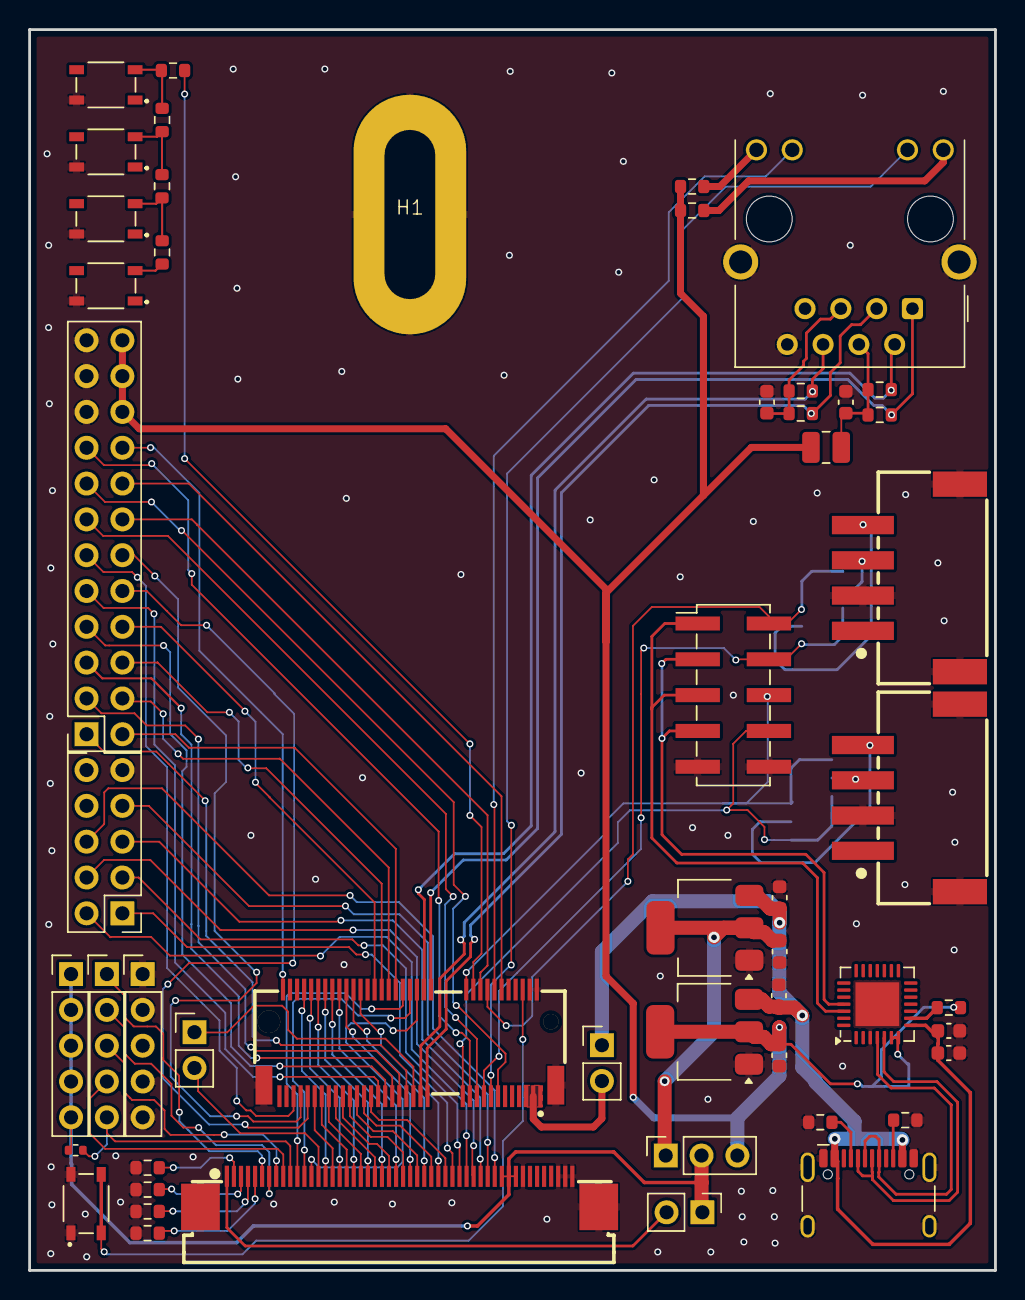
[picture p9: board V3S-devboard-expansion-minimal.kicad_pcb from above]

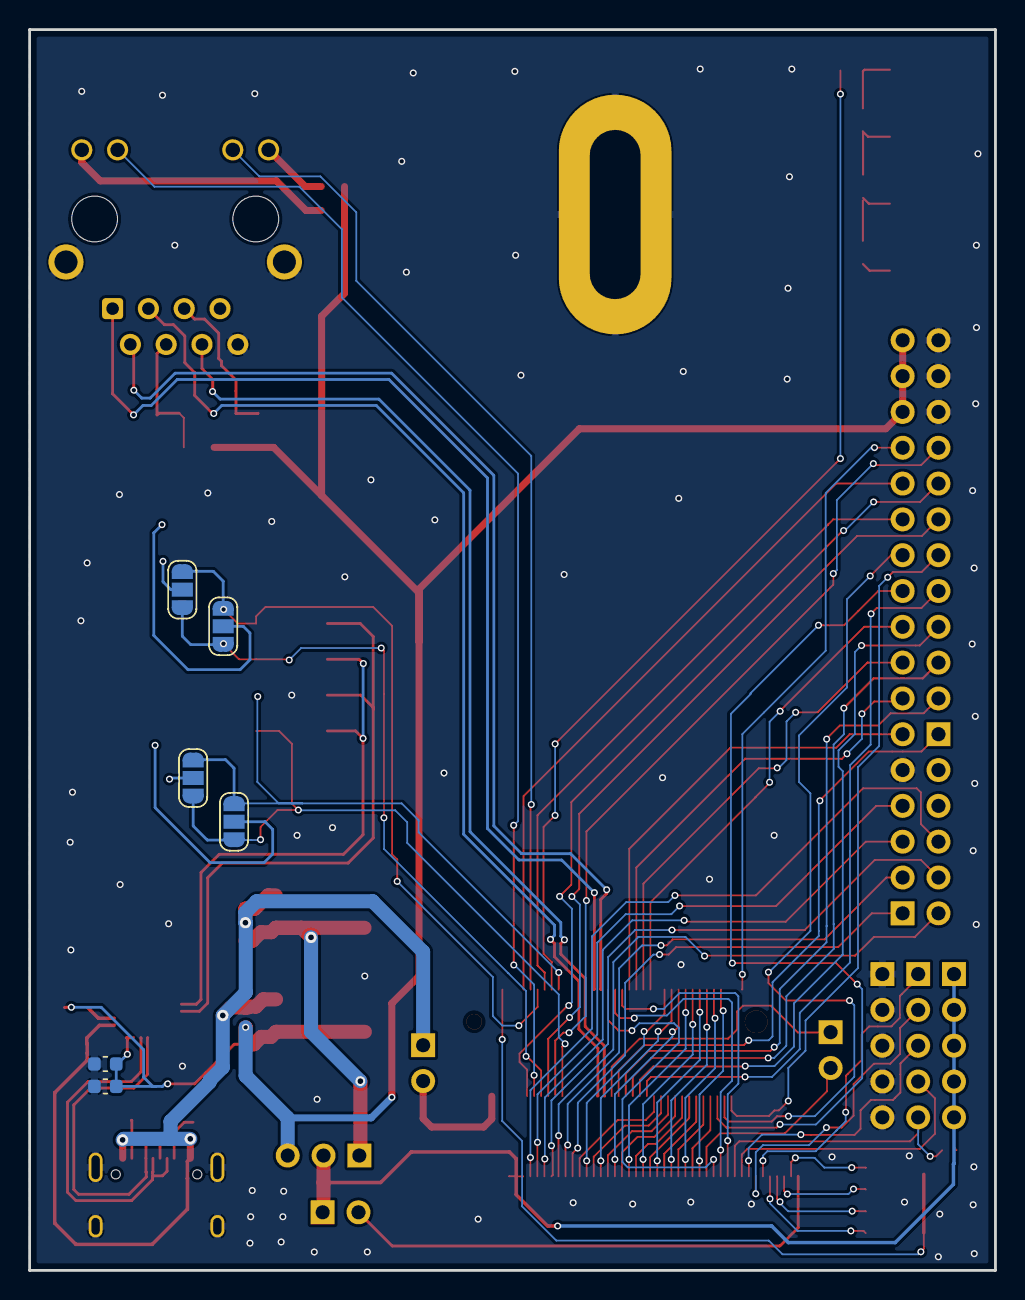
[picture p10: board V3S-devboard-expansion-minimal.kicad_pcb from below]

Board: 2 copper layers, 68.5 x 88.0 mm, 58 parts (6 on the bottom side), 95 nets.
