afonsus1997/V3S-devboard/(commit log)

2024-03-03 Started working in schematic
    [DIMM.kicad_sch, V3S-devboard-module.kicad_pcb, V3S-devboard-module.kicad_sch, V3S-devboard-sodimm.kicad_pcb, V3S-devboard-sodimm.kicad_sch, power.kicad_sch, uP.kicad_sch]
2024-03-07 minor changes
    [DIMM.kicad_sch, power.kicad_sch, uP.kicad_sch]
2024-03-07 more shcematic
    [uP.kicad_sch]
2024-03-07 more schematic changes
    [V3S-devboard-module.kicad_sch, uP.kicad_sch]
2024-03-12 schematic work
    [DIMM.kicad_sch, uP.kicad_sch]
2024-03-13 small improvements
    [V3S-devboard-module.kicad_pcb]
2024-03-13 added some power connections
    [DIMM.kicad_sch, power.kicad_sch, uP.kicad_sch]
2024-03-22 schematic improvements
    [DIMM.kicad_sch, V3S-devboard-module.kicad_pcb, V3S-devboard-module.kicad_sch, power.kicad_sch, uP.kicad_sch]
2024-03-23 Removed old project. Schematic improvements
    [DIMM.kicad_sch, V3S-devboard-module.kicad_sch, ext_conn.kicad_sch, uP.kicad_sch]
2024-03-26 general improvements. power almost complete
    [V3S-devboard-module.kicad_pcb, V3S-devboard-module.kicad_sch, ext_conn.kicad_sch, power.kicad_sch, uP.kicad_sch]
2024-03-26 new power designators
    [power.kicad_sch]
2024-03-26 CPU schematic improvements
    [V3S-devboard-module.kicad_sch, uP.kicad_sch]
2024-03-26 minor improvements and fixes
    [power.kicad_sch, uP.kicad_sch]
2024-03-27 fixed minor schematic issues
    [V3S-devboard-module.kicad_pcb, ext_conn.kicad_sch, power.kicad_sch, uP.kicad_sch]
2024-03-27 started preparing layout
    [V3S-devboard-module.kicad_pcb, uP.kicad_sch]
2024-03-27 layout improvements.
    [V3S-devboard-module.kicad_pcb, power.kicad_sch]
2024-03-28 some layout
    [V3S-devboard-module.kicad_pcb, ext_conn.kicad_sch, power.kicad_sch]
2024-03-29 layout testing
    [V3S-devboard-module.kicad_pcb, ext_conn.kicad_sch]
2024-03-29 more layout testing
    [V3S-devboard-module.kicad_pcb, ext_conn.kicad_sch]
2024-04-02 small layout
    [V3S-devboard-module.kicad_pcb, uP.kicad_sch]
2024-04-03 more tests
    [V3S-devboard-module.kicad_pcb, ext_conn.kicad_sch, uP.kicad_sch]
2024-04-04 more layout
    [V3S-devboard-module.kicad_pcb, ext_conn.kicad_sch, power.kicad_sch, uP.kicad_sch]
2024-04-06 re-annotated everything
    [V3S-devboard-module.kicad_pcb, power.kicad_sch, uP.kicad_sch]
2024-04-07 pre production tests
    [V3S-devboard-module.kicad_pcb, ext_conn.kicad_sch, power.kicad_sch, uP.kicad_sch]
2024-04-07 minor fixes
    [V3S-devboard-module.kicad_pcb]
2024-04-07 started working on exp board
    [V3S-devboard-expansion-minimal.kicad_pcb, V3S-devboard-expansion-minimal.kicad_sch, V3S-devboard-module.kicad_pcb]
2024-04-08 expansion board work
    [V3S-devboard-expansion-minimal.kicad_pcb, V3S-devboard-expansion-minimal.kicad_sch, V3S-devboard-module.kicad_pcb]
2024-04-10 expansion layout and schematic
    [V3S-devboard-expansion-minimal.kicad_pcb, V3S-devboard-expansion-minimal.kicad_sch]
2024-04-10 expansion board layout
    [V3S-devboard-expansion-minimal.kicad_pcb]
2024-04-11 working on final touches
    [V3S-devboard-expansion-minimal.kicad_pcb, V3S-devboard-expansion-minimal.kicad_sch, V3S-devboard-module.kicad_pcb, power.kicad_sch]
2024-04-11 Minor changes. Sent to fab
    [V3S-devboard-expansion-minimal.kicad_pcb, V3S-devboard-expansion-minimal.kicad_sch, V3S-devboard-module.kicad_pcb]
2024-04-12 fixed clearance problems, sent to fab
    [V3S-devboard-expansion-minimal.kicad_pcb, V3S-devboard-module.kicad_pcb]
2024-04-12 changed clearances for devboard, sent to fab
    [V3S-devboard-module.kicad_pcb]
2024-04-12 sent to fab... again
    [V3S-devboard-module.kicad_pcb]
2024-04-12 Minor changed. Final version sent to fab (really)
    [V3S-devboard-module.kicad_pcb]
2024-04-30 wrong order of pins of regulator
    [V3S-devboard-module.kicad_pcb]
